dddddddddl/smart-dehumidification-cabinet/docs/README.md

# Project materials and reading guide

| Material | Use |
|---|---|
| [Main README](../README.md) | Overview and recommended reading order |
| [Protocol](protocol.md) | Serial fields, browser routes and state semantics |
| [Validation](validation.md) | Executed checks and hardware boundaries |
| [Provenance](provenance.md) | Source selection, preparation changes and exclusions |
| [English presentation](presentation/project_overview.pptx) | Six-slide technical overview |
| [Project demonstration](media/README.md) | Separately packaged video and checksum |
| [Hardware](../hardware/README.md) | PCB, native CAD and meshes |
| [Voice module](../voice/README.md) | Original template, English command reference and binary availability |

The presentation preserves the original technical design and historical feedback. Its feedback statements are not a newly conducted user study or quantitative performance evaluation. The certificate was used only to describe the award and is not included.
