dddddddddl/smart-dehumidification-cabinet/docs/presentation/project_overview.pptx

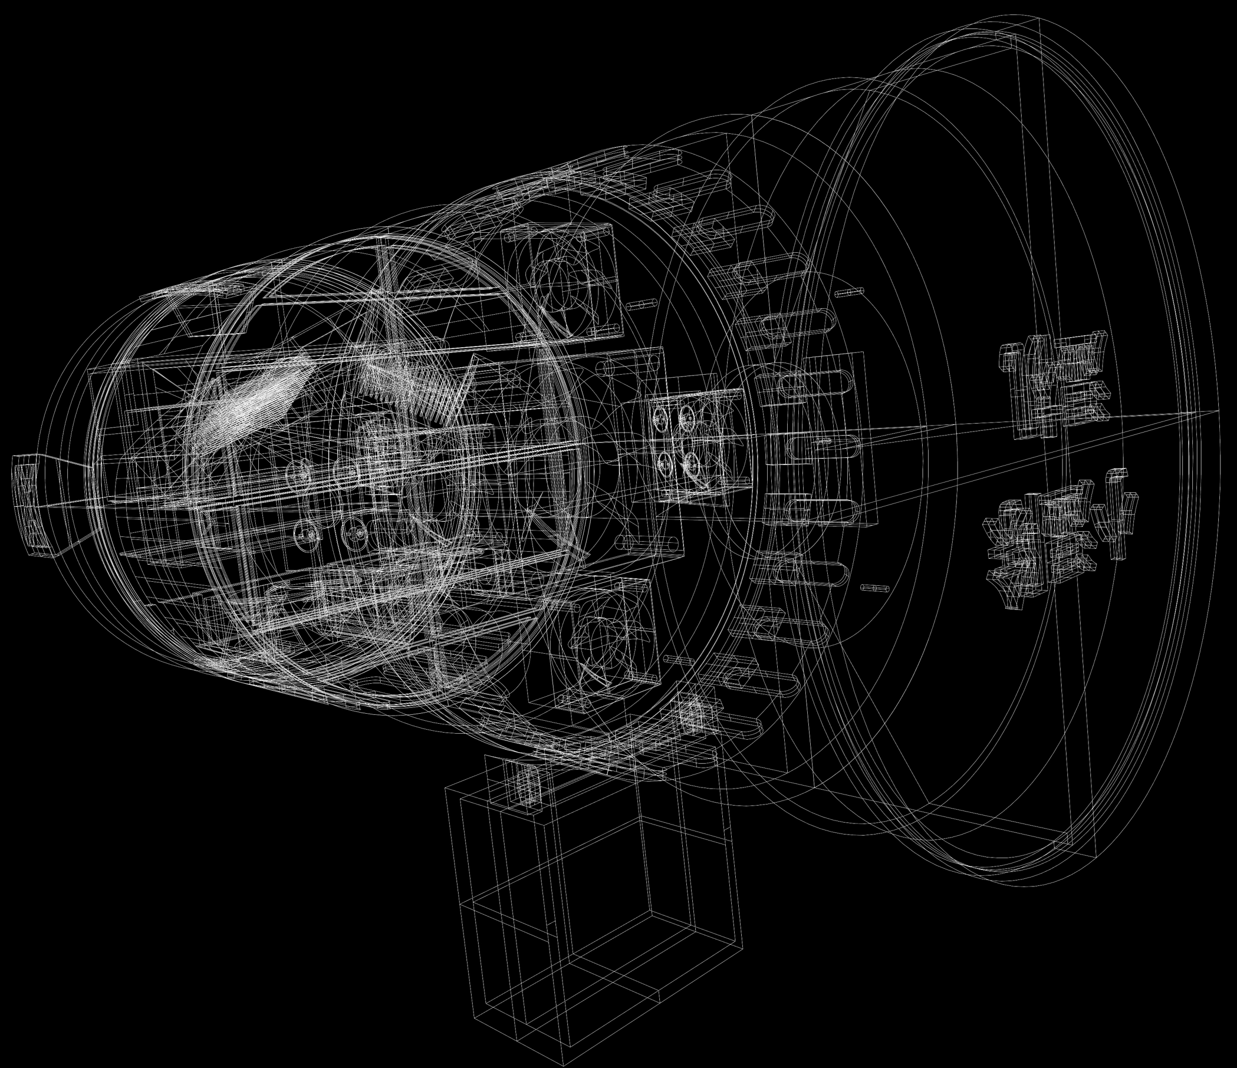
[picture p3: figure]

XIAOSHI

An Intelligent Household Dehumidification and Auxiliary PURIFICATION SYSTEM

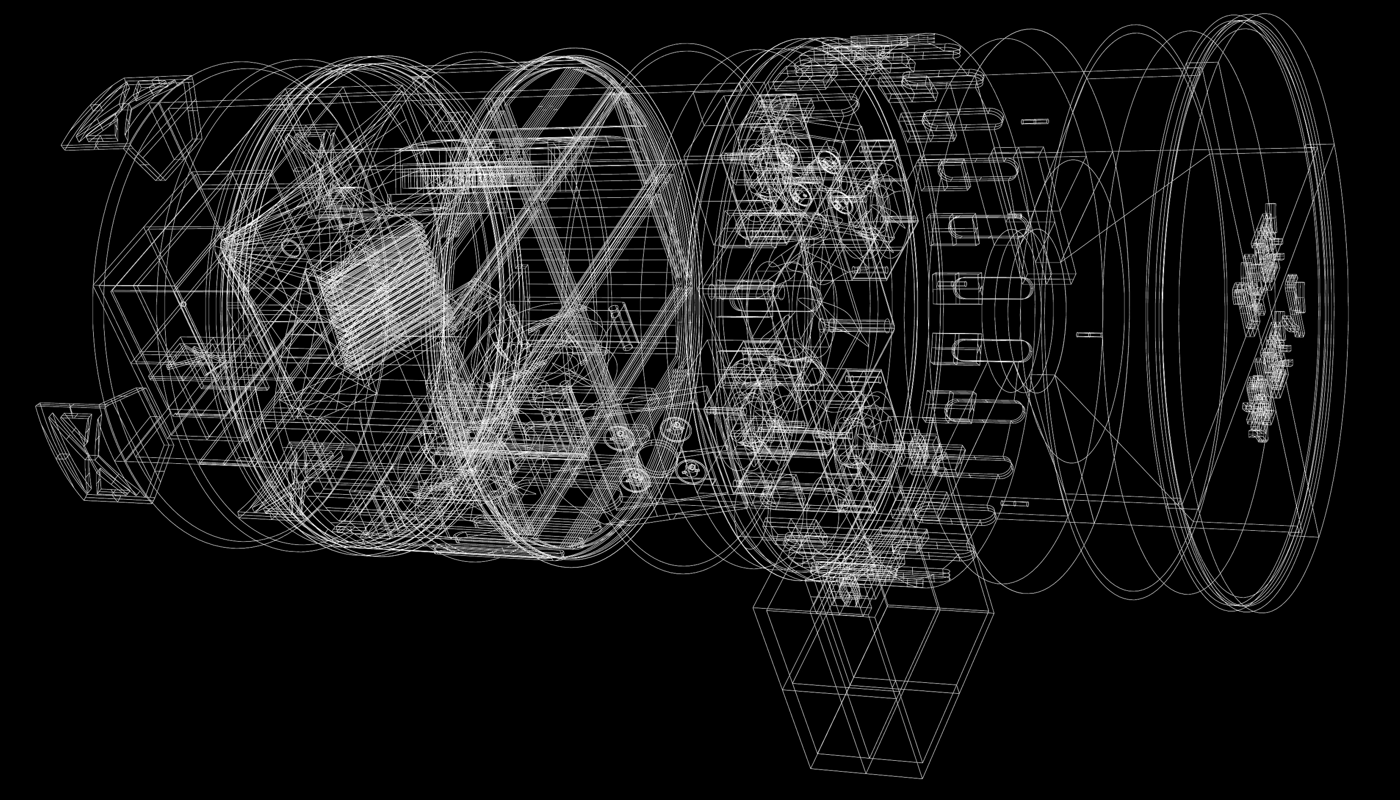
[picture p4: figure]

Embedded Control
Connected Dashboard
Modular Hardware

Notes: Xiaoshi is an embedded dehumidification cabinet prototype intended for small enclosed storage spaces. Its design combines silica-gel handling and thermoelectric condensation with local controls and a browser dashboard. Source: supplied MEC202 Demo.zip, DemonstrationPPT.pptx, slides 1-4.

## Slide 2

Background & Requirements

High humidity problems
High humidity can cause discomfort, mold growth, and damage to stored items such as clothes, books, wooden products and musical instruments.

Target Users
Users who need dry, clean storage for valuable items and prefer convenient monitoring and control of enclosed spaces.

User Need | Design Requirement
Reduce humidity | Dehumidification function
Monitor environmental status | Environmental data display
Improve air quality | Improve air quality
Easy operation | Easy operation
Fit small spaces | Fit small spaces

Notes: The original presentation identifies humidity control, environmental status display, convenient operation and a compact enclosure as design requirements. Air-quality improvement is a design goal in that material. The supplied package does not contain a quantified purification evaluation. Source: supplied DemonstrationPPT.pptx, slide 2.

## Slide 3

System Architecture & Design Features

Hardware Design Features

Compact Layered Structure
For small enclosed storage spaces.
Dual Dehumidification
Silica-gel adsorption and TEC condensation.
Auxiliary UV Layer
UV/TiO₂ design; efficacy not measured.
Water and Thermal Checks
Water cutoff and temperature-limited PWM.

Feeding area

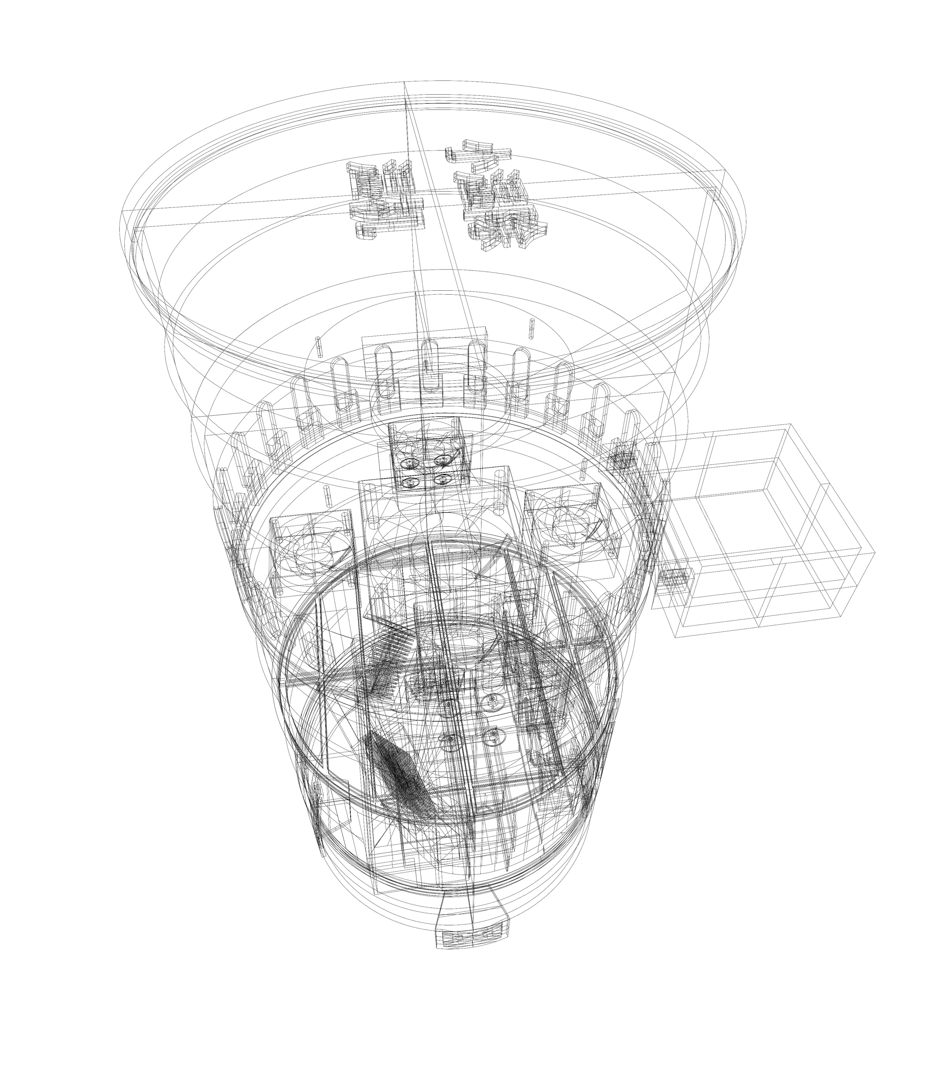
[picture p5: figure]

Silica-gel desiccant layer

Fan Layer

UV catalytic Layer

TEC Condensation Layer

Control Layer

TFT Screen With knob control

Notes: The layered design includes a silica-gel desiccant section, fan, auxiliary UV/TiO2 feature, thermoelectric condensation section and controller. The ATmega2560 firmware contains a humidity PID and a second PID that limits PWM according to Peltier temperature, with a 60 C setpoint, plus water-level cutoff logic. The materials do not establish measured purification efficacy or verified protection under sensor faults. Sources: supplied DemonstrationPPT.pptx, slide 3; ArduinoMegaCode/src/main.cpp, PIDController, loop and updateHardwareState.

## Slide 4

System Architecture & Design Features

User Interaction Design Features

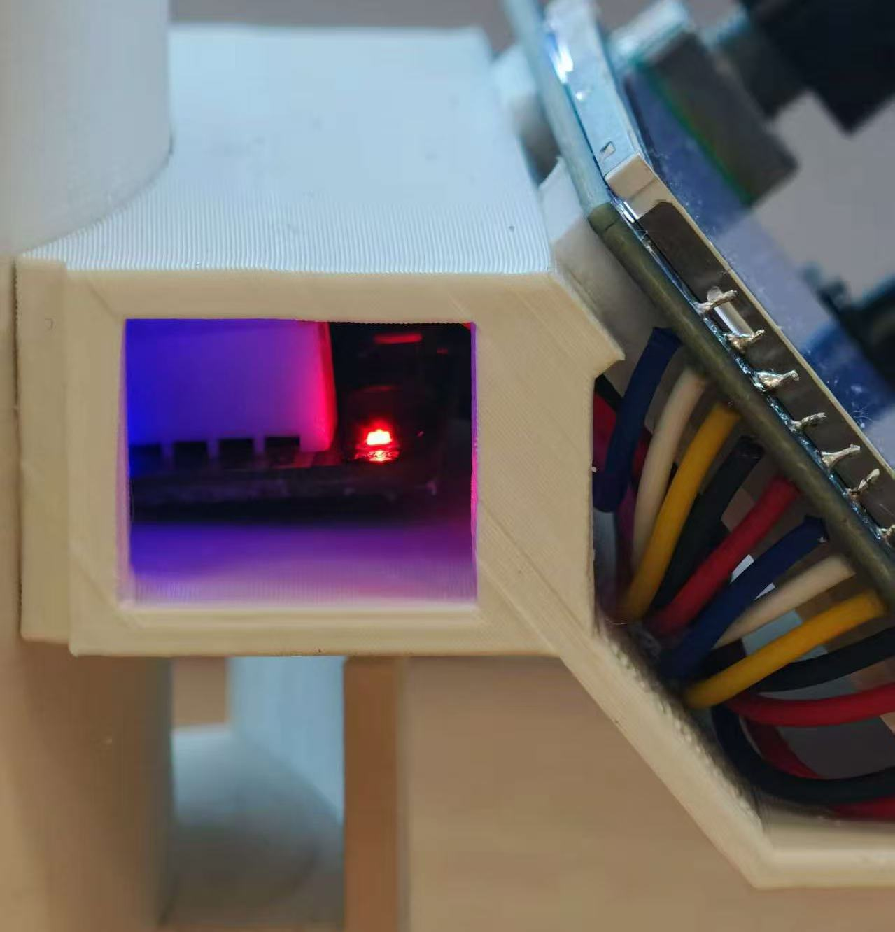
[picture p6: figure]

Voice Recognition

Voice command interface.
Module configuration needs verification.

Web-Based Control


Browser status and controls.
Standby and running views.

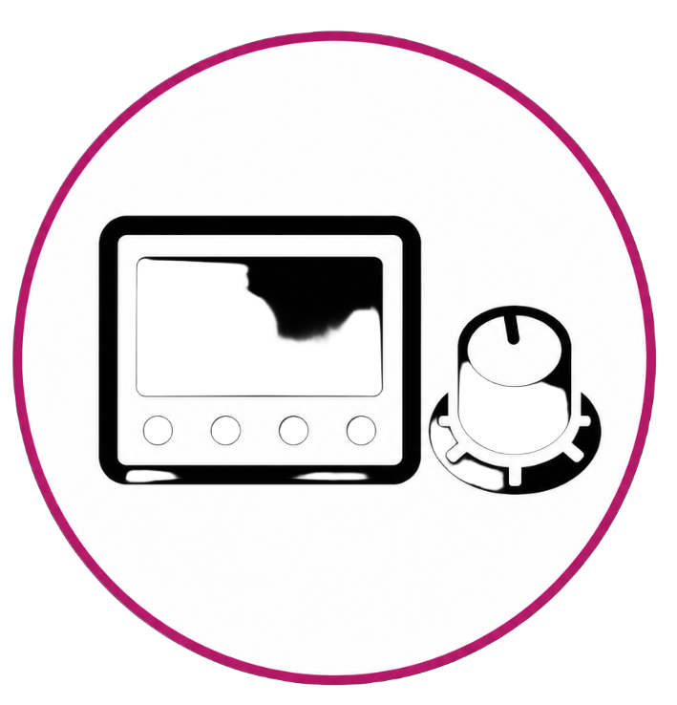
[picture p7: figure]

TFT Display & Local Control

Displays device status and supports knob control.

Notes: The project includes a TFT and encoder interface, an ESP8266 browser dashboard, and voice-command materials. The supplied Mega code reads voice results over I2C, while the supplied voice filename and workbook refer to UART frames. A matching module configuration and end-to-end voice operation need hardware verification. Sources: supplied DemonstrationPPT.pptx, slide 4; ArduinoMegaCode/src/main.cpp, readASRResult and handleVoiceCommand; VoiceRecognitionModuleFirmware/XIAOSHI.xlsx.

## Slide 5

Testing Demo

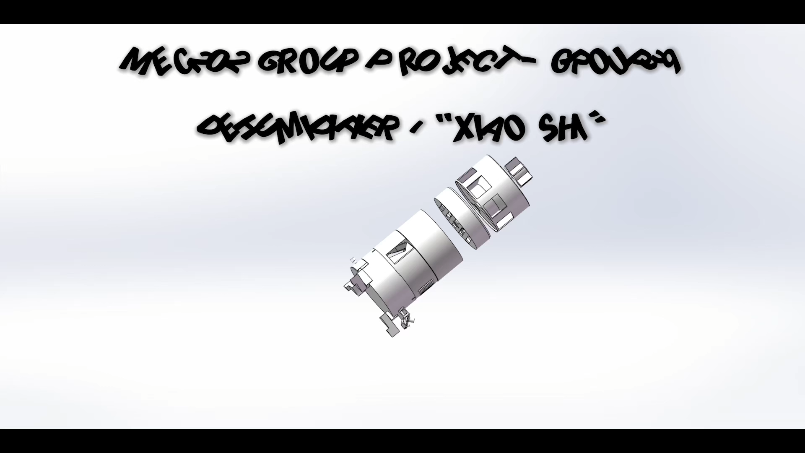
[picture p8: figure]

Notes: This slide introduces the supplied historical demonstration. The public release retains its timeline and audio, with a replacement title card covering the participant roster. It is a demonstration artifact and does not provide a new quantified dehumidification or purification experiment. Source: supplied MEC202 Demo.zip, DemonstrationVideo.mp4; see docs/media/README.md for the public copy.

## Slide 6

Feedback and Next Steps

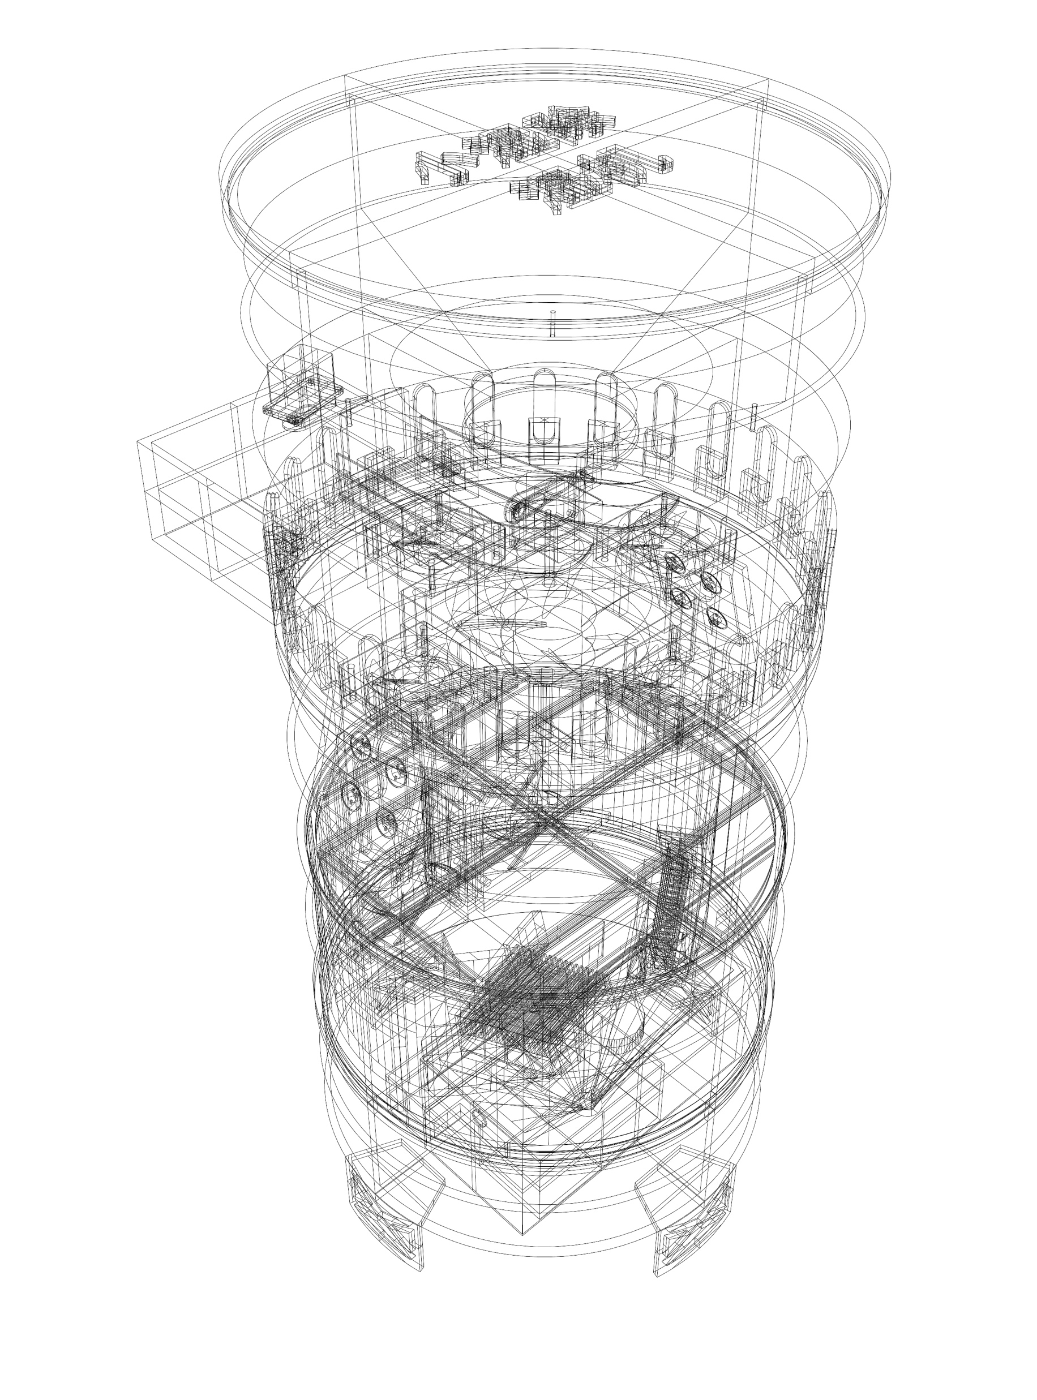
[picture p9: figure]

Users Feedback

Control: ease of use

Protection: water-level and thermal checks

Dehumidification: enclosed-space use

Future Improvement
- Improve voice recognition accuracy
- Water–electricity separation

Notes: The original final slide reports qualitative feedback and proposes improving voice recognition and water/electrical separation. No survey protocol, participant count or quantitative feedback results accompany those statements. Water-level and thermal checks refer to implemented controller logic rather than verified fault tolerance. Source: supplied DemonstrationPPT.pptx, slide 6; ArduinoMegaCode/src/main.cpp.
