dddddddddl/smart-dehumidification-cabinet/hardware/mechanical/deviceLayerBottom4.21.STL

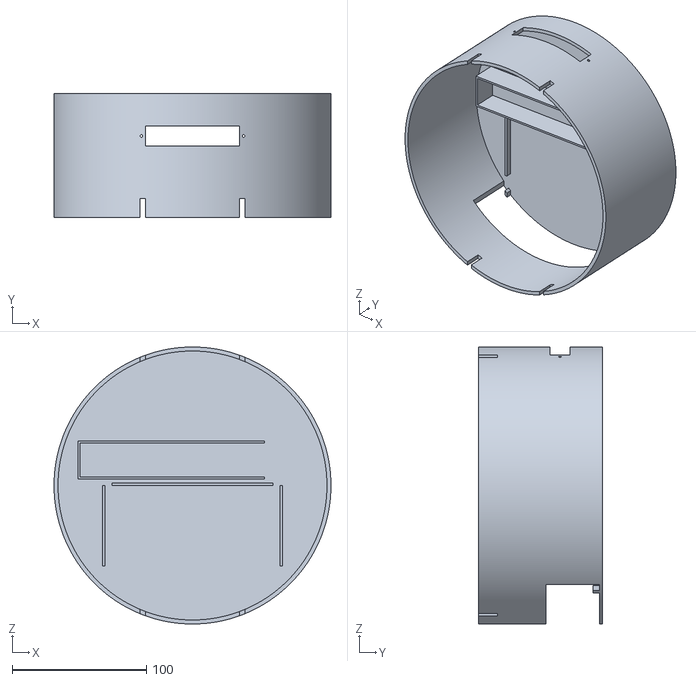
[picture p10: CAD file, 2026-10-15]
hardware/mechanical/deviceLayerBottom4.21.STL
206.0 x 92.0 x 206.0
