dddddddddl/smart-dehumidification-cabinet/hardware/mechanical/heatDisspation.step.SLDPRT

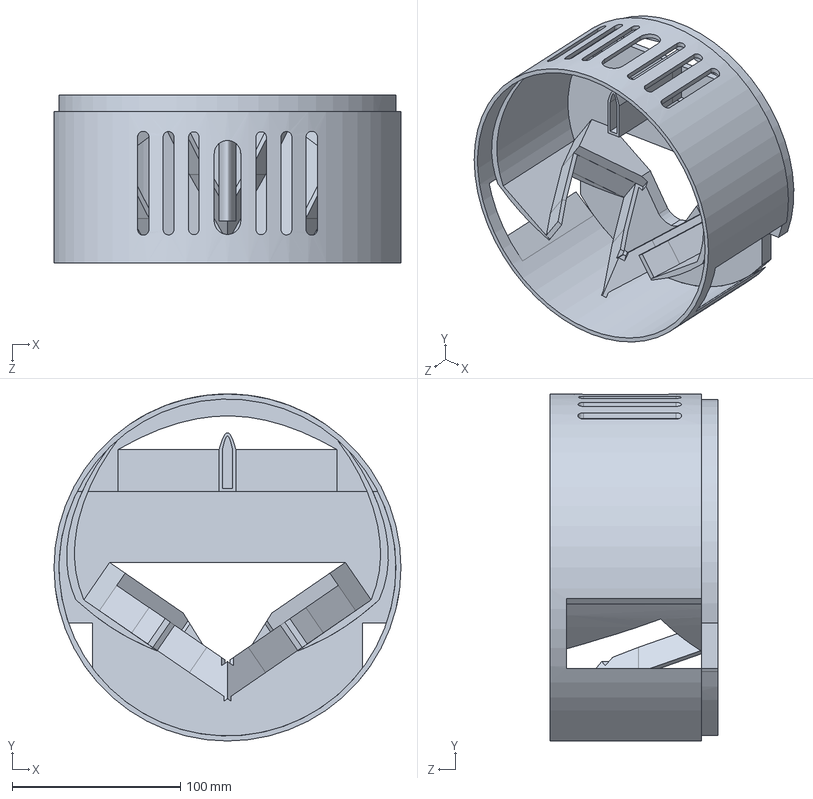
[picture p11: CAD file, 2026-10-15]
hardware/mechanical/heatDisspation.step.SLDPRT
206.0 x 206.0 x 100.0 mm
