dddddddddl/smart-dehumidification-cabinet/hardware/mechanical/bigLeaf4-24.STL

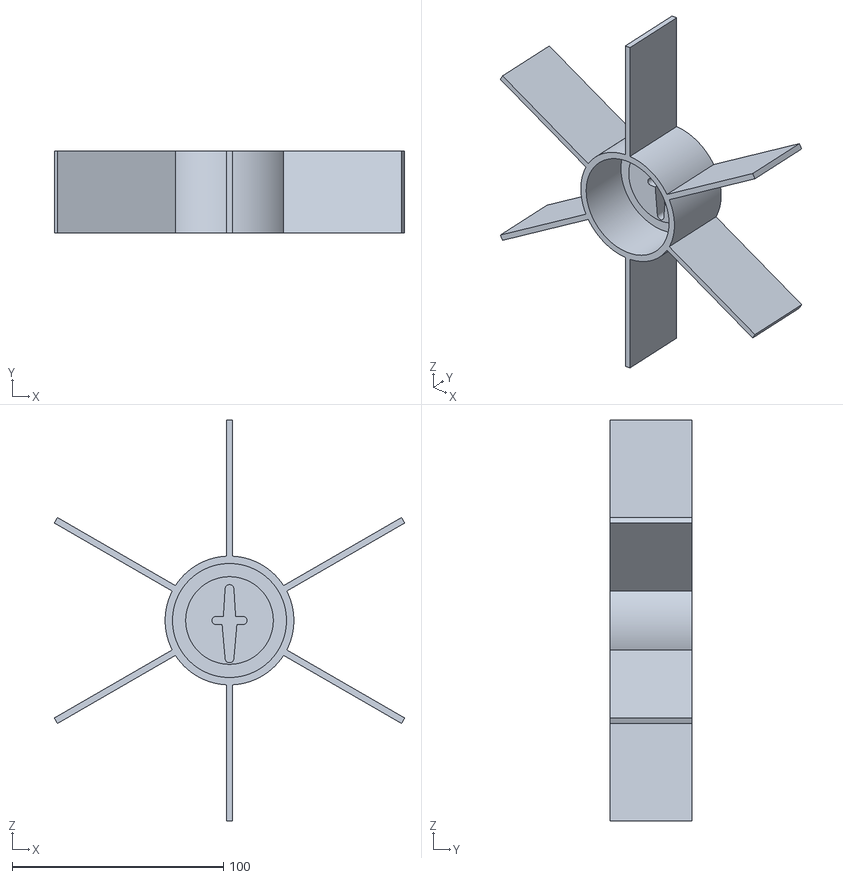
[picture p12: CAD file, 2026-10-15]
hardware/mechanical/bigLeaf4-24.STL
166.0 x 39.0 x 190.0
