dddddddddl/smart-dehumidification-cabinet/hardware/mechanical/catalyzeLayer.SLDPRT

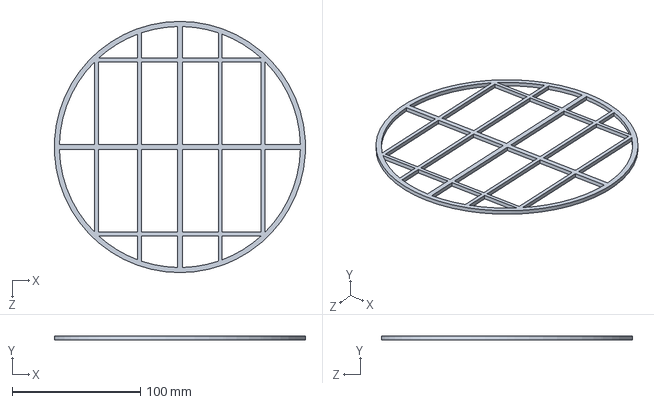
[picture p13: CAD file, 2026-10-15]
hardware/mechanical/catalyzeLayer.SLDPRT
195.8 x 3.00 x 196.0 mm
