dddddddddl/smart-dehumidification-cabinet/hardware/mechanical/waterTankArm.STL

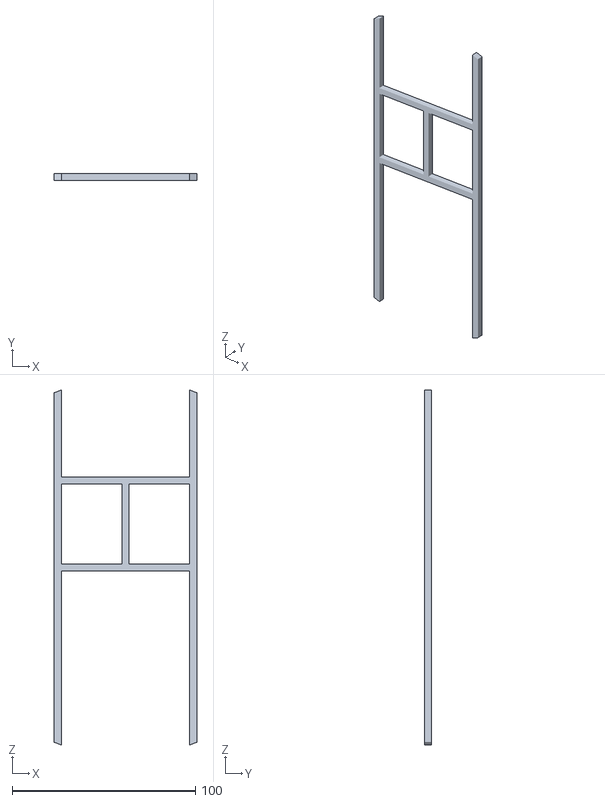
[picture p14: CAD file, 2026-10-15]
hardware/mechanical/waterTankArm.STL
78.0 x 4.00 x 193.7
