dddddddddl/smart-dehumidification-cabinet/hardware/mechanical/screen.SLDPRT

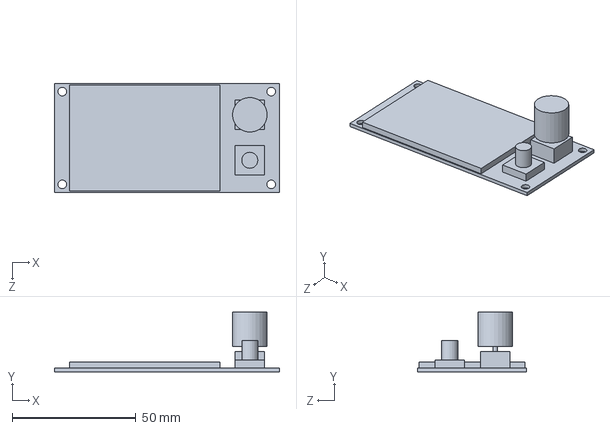
[picture p15: CAD file, 2026-10-15]
hardware/mechanical/screen.SLDPRT
91.0 x 24.2 x 44.0 mm
