dddddddddl/smart-dehumidification-cabinet/hardware/mechanical/TOPmaterial4.25.STL

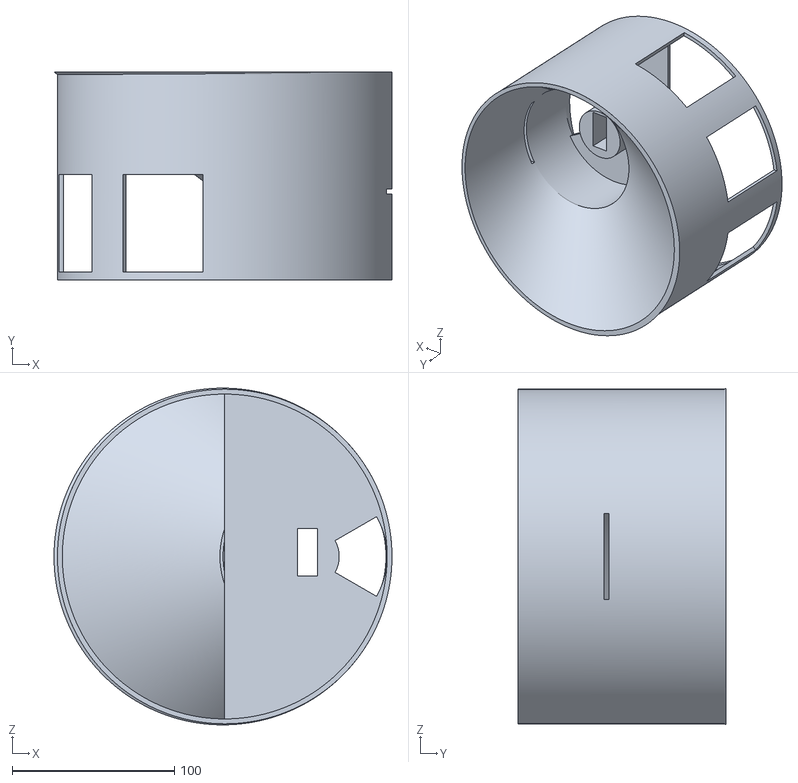
[picture p16: CAD file, 2026-10-15]
hardware/mechanical/TOPmaterial4.25.STL
208.1 x 128.0 x 207.4
