dddddddddl/smart-dehumidification-cabinet/hardware/mechanical/TOPmaterialGasket.SLDPRT

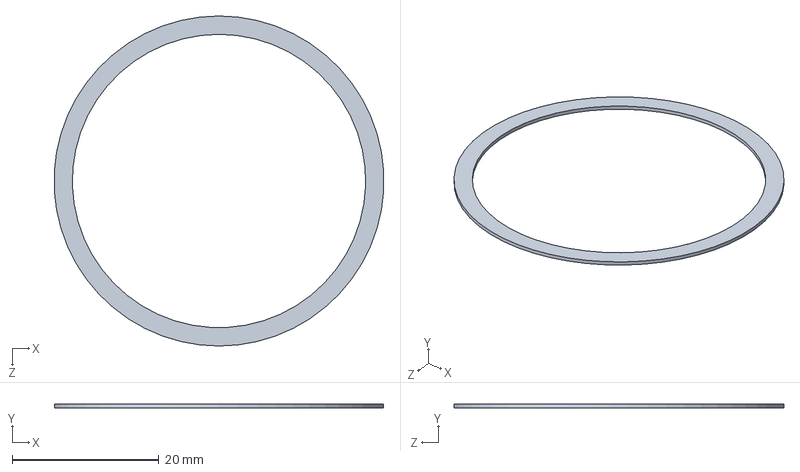
[picture p17: CAD file, 2026-10-15]
hardware/mechanical/TOPmaterialGasket.SLDPRT
44.9 x 0.5 x 45.0 mm
