dddddddddl/smart-dehumidification-cabinet/hardware/mechanical/0.5mmgasket.SLDPRT

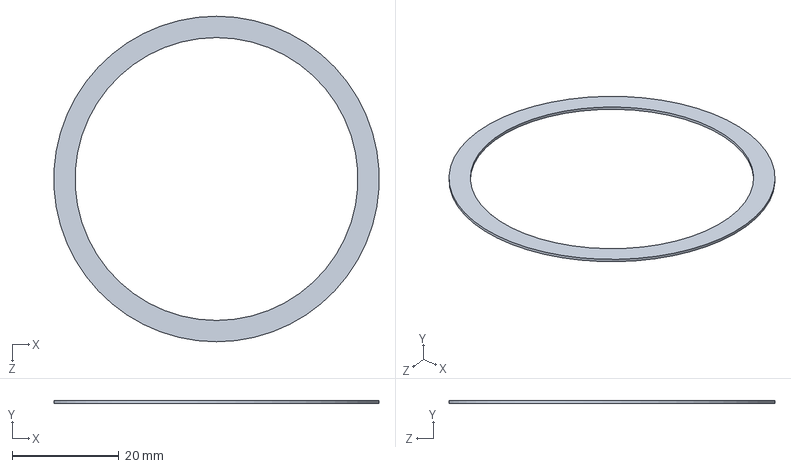
[picture p18: CAD file, 2026-10-15]
hardware/mechanical/0.5mmgasket.SLDPRT
60.9 x 0.5 x 61.0 mm
