dddddddddl/smart-dehumidification-cabinet/hardware/mechanical/board.SLDPRT

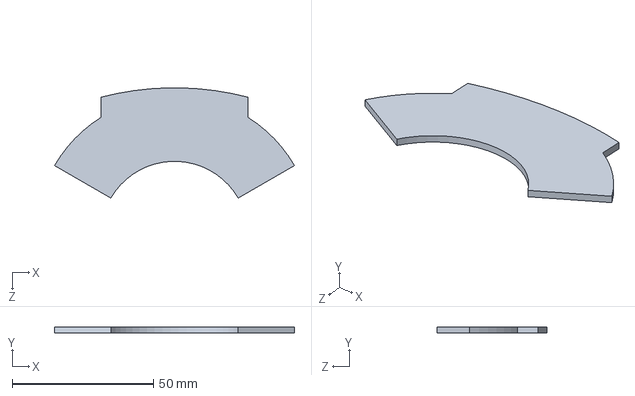
[picture p19: CAD file, 2026-10-15]
hardware/mechanical/board.SLDPRT
84.9 x 2.00 x 39.0 mm
