dddddddddl/smart-dehumidification-cabinet/hardware/mechanical/holder1.SLDPRT

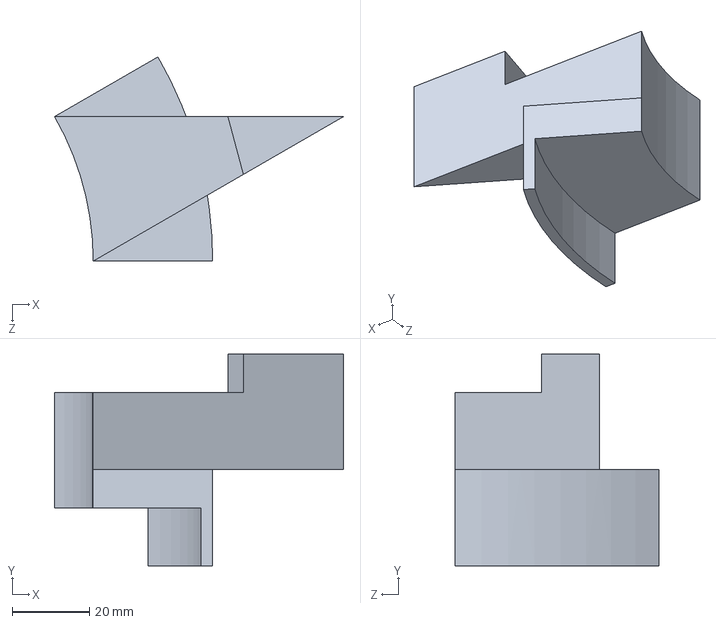
[picture p20: CAD file, 2026-10-15]
hardware/mechanical/holder1.SLDPRT
75.0 x 55.0 x 53.0 mm
