dddddddddl/smart-dehumidification-cabinet/hardware/mechanical/screenHolder.SLDPRT

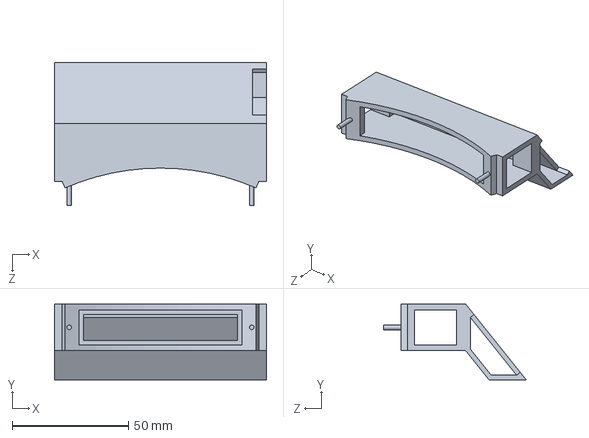
[picture p21: CAD file, 2026-10-15]
hardware/mechanical/screenHolder.SLDPRT
91.0 x 32.5 x 61.2 mm
