dddddddddl/smart-dehumidification-cabinet/hardware/mechanical/slope.SLDPRT

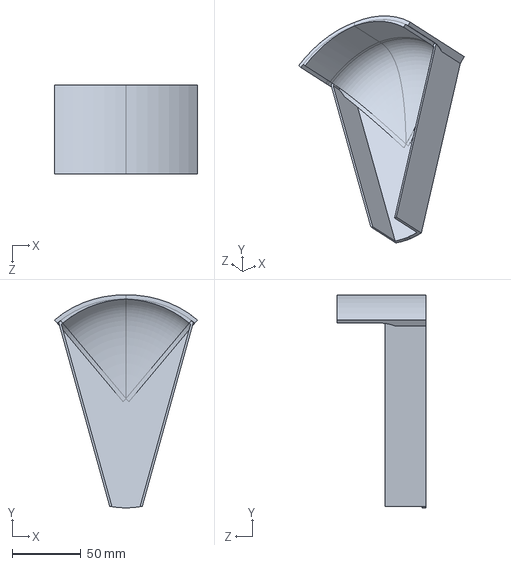
[picture p22: CAD file, 2026-10-15]
hardware/mechanical/slope.SLDPRT
104.4 x 155.5 x 65.0 mm
