dddddddddl/smart-dehumidification-cabinet/hardware/mechanical/watertank.SLDPRT

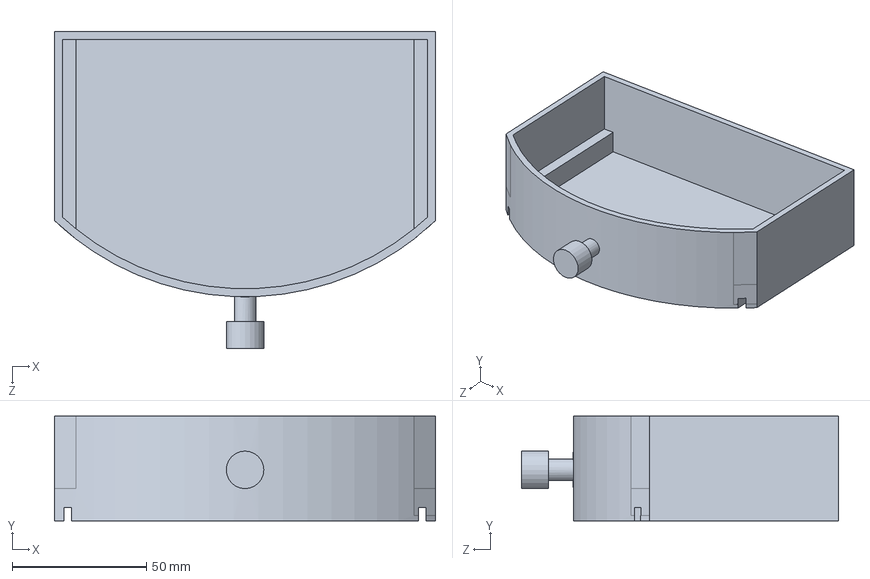
[picture p23: CAD file, 2026-10-15]
hardware/mechanical/watertank.SLDPRT
142.0 x 39.0 x 118.0 mm
