dddddddddl/smart-dehumidification-cabinet/hardware/mechanical/adapterUV2outlet.SLDPRT

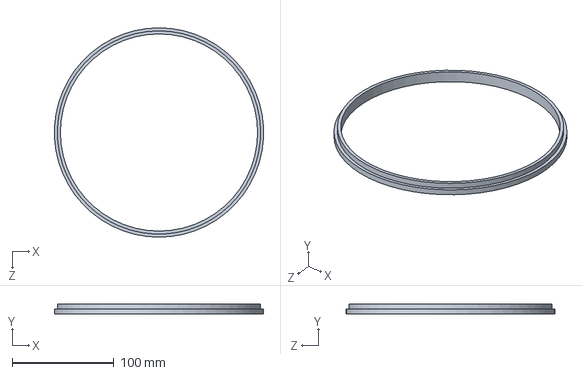
[picture p24: CAD file, 2026-10-15]
hardware/mechanical/adapterUV2outlet.SLDPRT
205.7 x 10.0 x 206.0 mm
