dddddddddl/smart-dehumidification-cabinet/hardware/mechanical/smallFan.SLDPRT

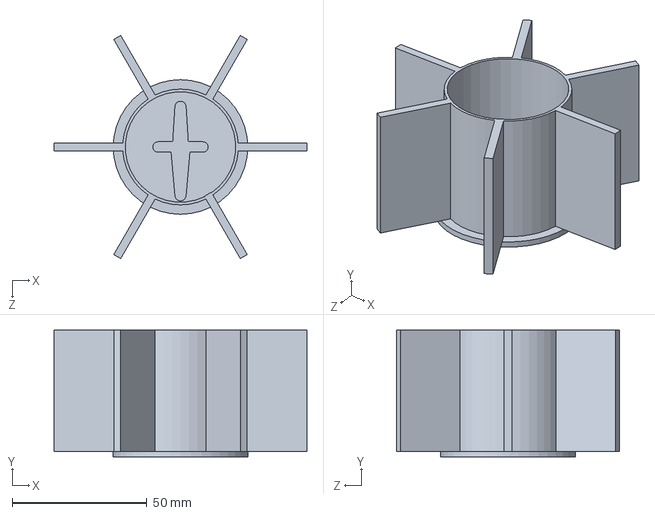
[picture p25: CAD file, 2026-10-15]
hardware/mechanical/smallFan.SLDPRT
94.0 x 47.0 x 82.9 mm
