dddddddddl/smart-dehumidification-cabinet/hardware/mechanical/inlet.SLDPRT

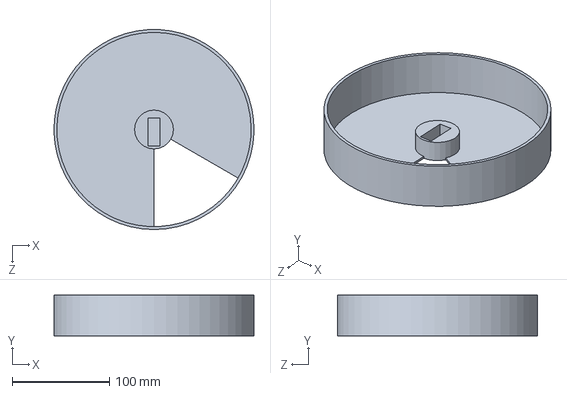
[picture p26: CAD file, 2026-10-15]
hardware/mechanical/inlet.SLDPRT
205.9 x 42.0 x 206.0 mm
