dddddddddl/smart-dehumidification-cabinet/hardware/mechanical/silicaGelLayer.SLDPRT

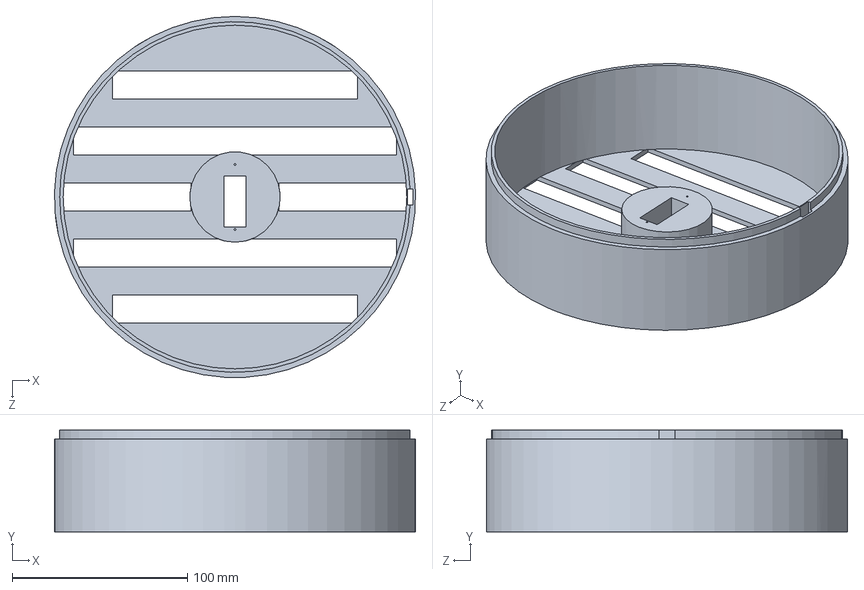
[picture p27: CAD file, 2026-10-15]
hardware/mechanical/silicaGelLayer.SLDPRT
205.9 x 58.0 x 206.0 mm
