dddddddddl/smart-dehumidification-cabinet/hardware/mechanical/UV.SLDPRT

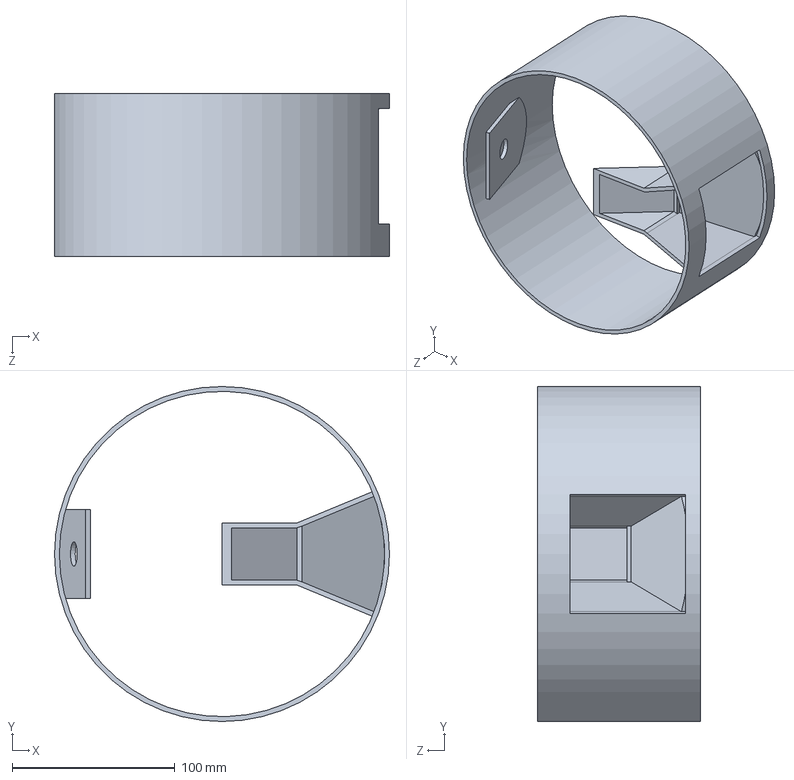
[picture p28: CAD file, 2026-10-15]
hardware/mechanical/UV.SLDPRT
206.0 x 206.0 x 100.0 mm
