dddddddddl/smart-dehumidification-cabinet/hardware/mechanical/bigLeafUltra.STL

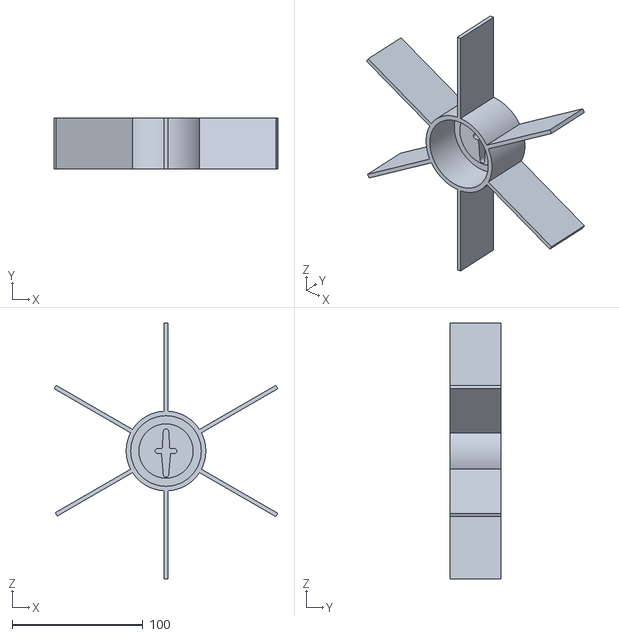
[picture p29: CAD file, 2026-10-15]
hardware/mechanical/bigLeafUltra.STL
171.2 x 39.0 x 196.0
