dddddddddl/smart-dehumidification-cabinet/hardware/mechanical/adaper-TEC-Fan.SLDPRT

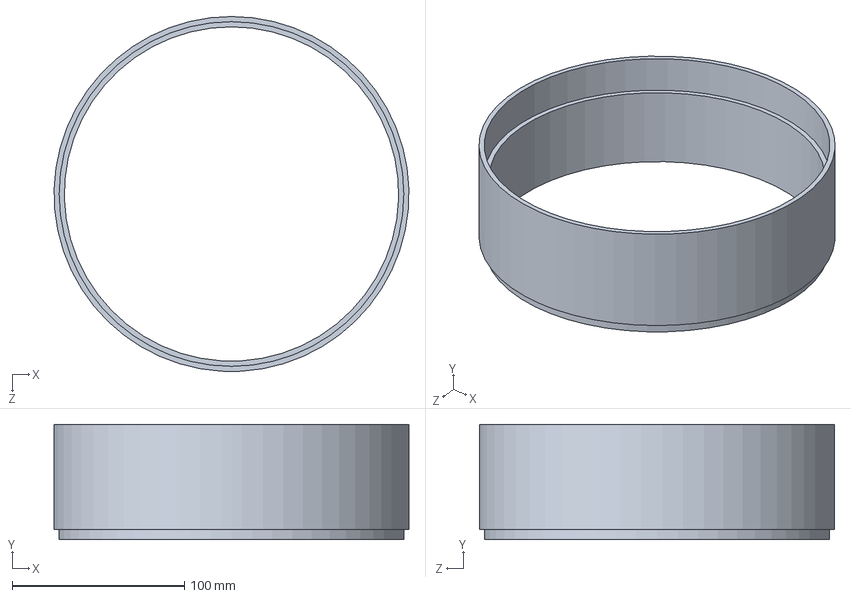
[picture p30: CAD file, 2026-10-15]
hardware/mechanical/adaper-TEC-Fan.SLDPRT
205.9 x 67.0 x 206.0 mm
