dddddddddl/smart-dehumidification-cabinet/hardware/mechanical/silicaGelLayerTotal.SLDASM

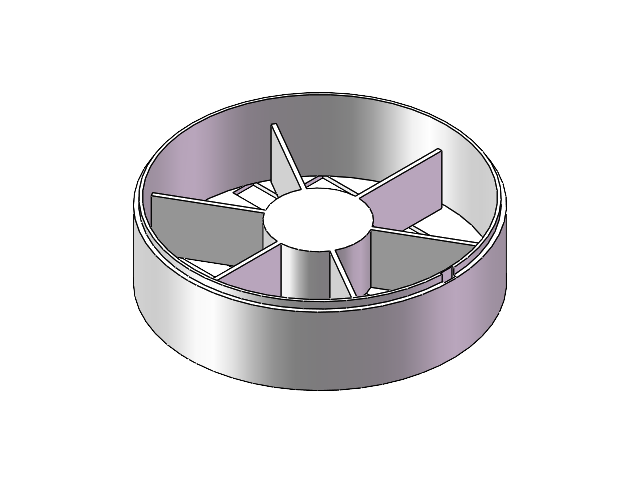
[picture p31: CAD file, 2026-10-15]
hardware/mechanical/silicaGelLayerTotal.SLDASM
硅胶吸附
桨叶
