dddddddddl/smart-dehumidification-cabinet/hardware/mechanical/total.SLDASM

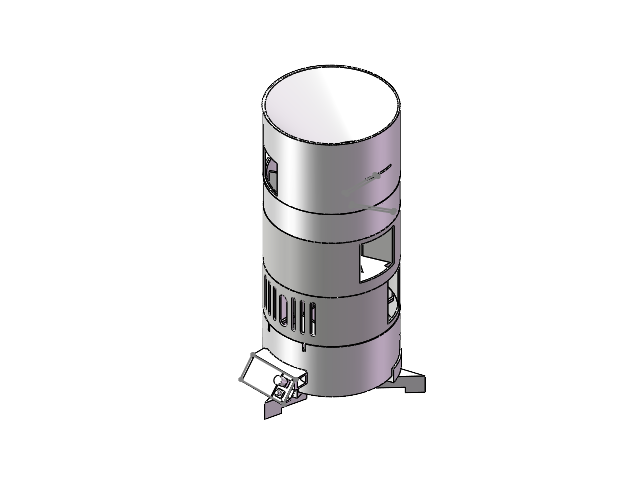
[picture p32: CAD file, 2026-10-15]
hardware/mechanical/total.SLDASM
顶部供料
零件2^total
小桨叶
硅胶吸附
桨叶
紫外线杀菌模块
物理散热模块.step
设备层底层
储水盒
水位传感器支架
屏幕支架
屏幕
支架1 x 3
催化剂支架
