dddddddddl/smart-dehumidification-cabinet/hardware/mechanical/lowestLayerTotal.SLDASM

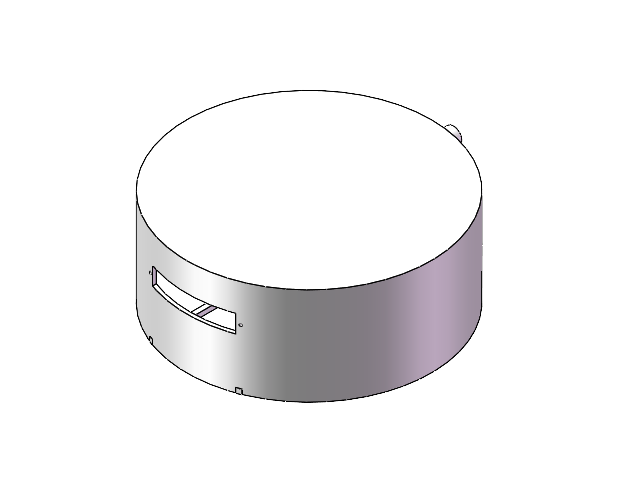
[picture p33: CAD file, 2026-10-15]
hardware/mechanical/lowestLayerTotal.SLDASM
设备层底层
储水盒
水位传感器支架
