dddddddddl/smart-dehumidification-cabinet/(list of files, cad)

Other CAD files:
hardware/mechanical/TOPmaterial.SLDPRT
hardware/mechanical/bigLeaf.SLDPRT
hardware/mechanical/smallFan4.25.STL
hardware/mechanical/deviceLayerBottom.SLDPRT
hardware/mechanical/waterSensorHolder.SLDPRT
hardware/mechanical/silicaGelLayer4-24.STL
hardware/mechanical/0.5mmgasket.STL
hardware/mechanical/TOPmaterial.STL
hardware/mechanical/TOPmaterialGasket.STL
hardware/mechanical/UV.STL
hardware/mechanical/adaper-TEC-Fan.STL
hardware/mechanical/adapterUV2outlet.STL
hardware/mechanical/bigLeaf.STL
hardware/mechanical/board.STL
hardware/mechanical/catalyzeLayer.STL
hardware/mechanical/deviceLayerBottom.STL
hardware/mechanical/holder1.STL
hardware/mechanical/inlet.STL
hardware/mechanical/screenHolder.STL
hardware/mechanical/silicaGelLayer.STL
hardware/mechanical/smallFan.STL
hardware/mechanical/watertank.STL
