dddddddddl/smart-dehumidification-cabinet/firmware/esp8266/include/local_config.example.h

#pragma once
// Copy to local_config.h for your own AP values; the local file is ignored.
#define DEHUMIDIFIER_AP_SSID "SmartDehumidifier-Demo"
#define DEHUMIDIFIER_AP_PASSWORD "REPLACE_WITH_A_UNIQUE_PASSWORD"
